simonkaufmann/AVR-USB-Flash-Drive/doc/avr_usb_flash_drive.pdf

USB Mass Storage

A USB Flash Drive with VUSB

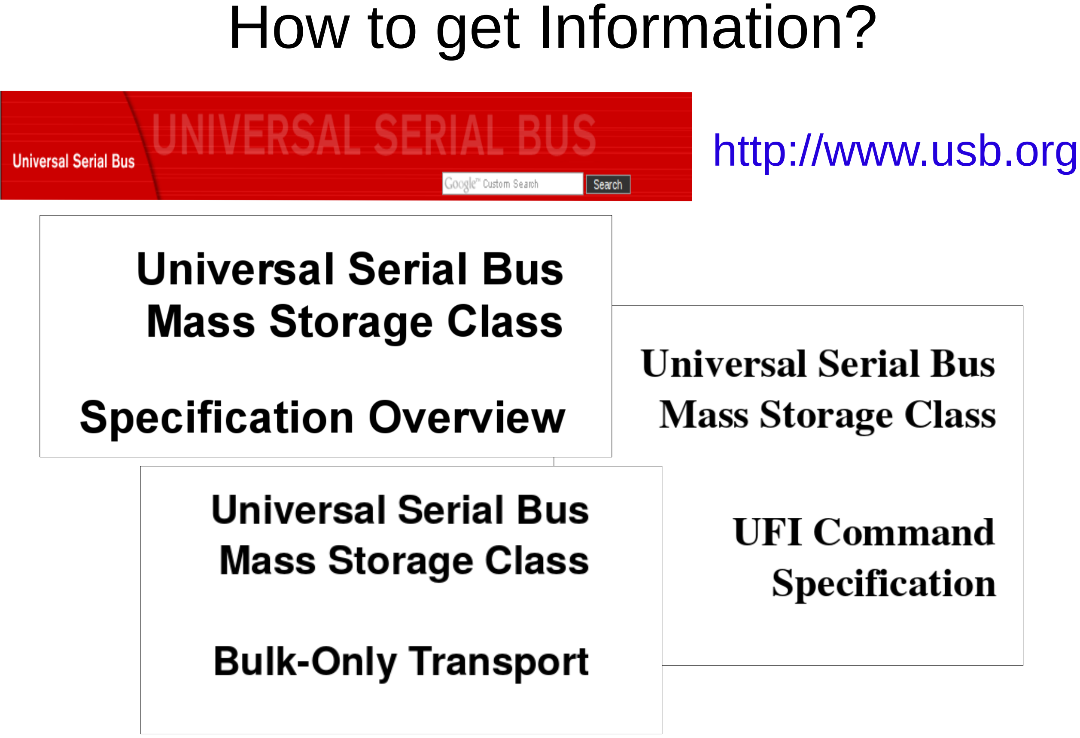
[picture p6: page 2]

How to get Information?

http://www.usb.org

VUSB and Bulk?

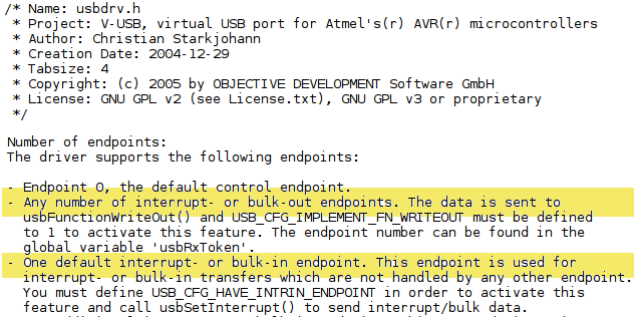
[picture p7: figure]

Linux Bulk

→ Restricts Low-Speed Bulk Endpoints

Test Low Speed Bulk Endpoints with Linux

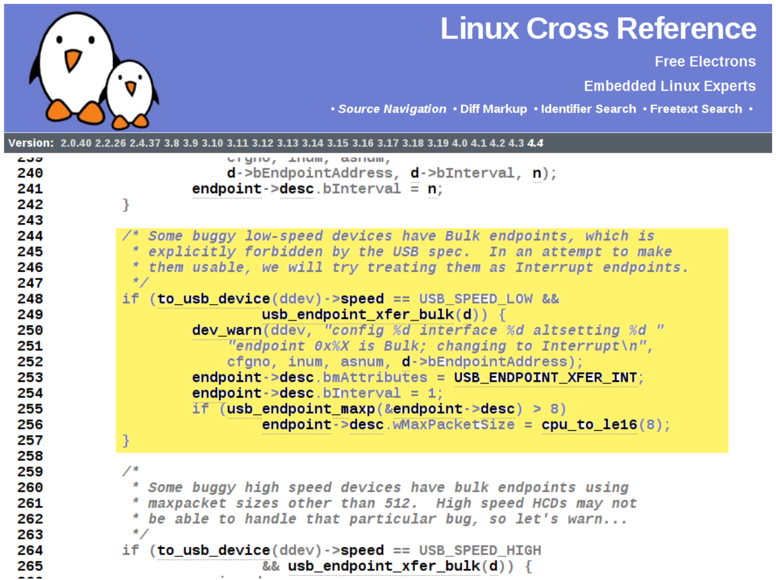
[picture p8: page 8]

Let's Hack the Kernel

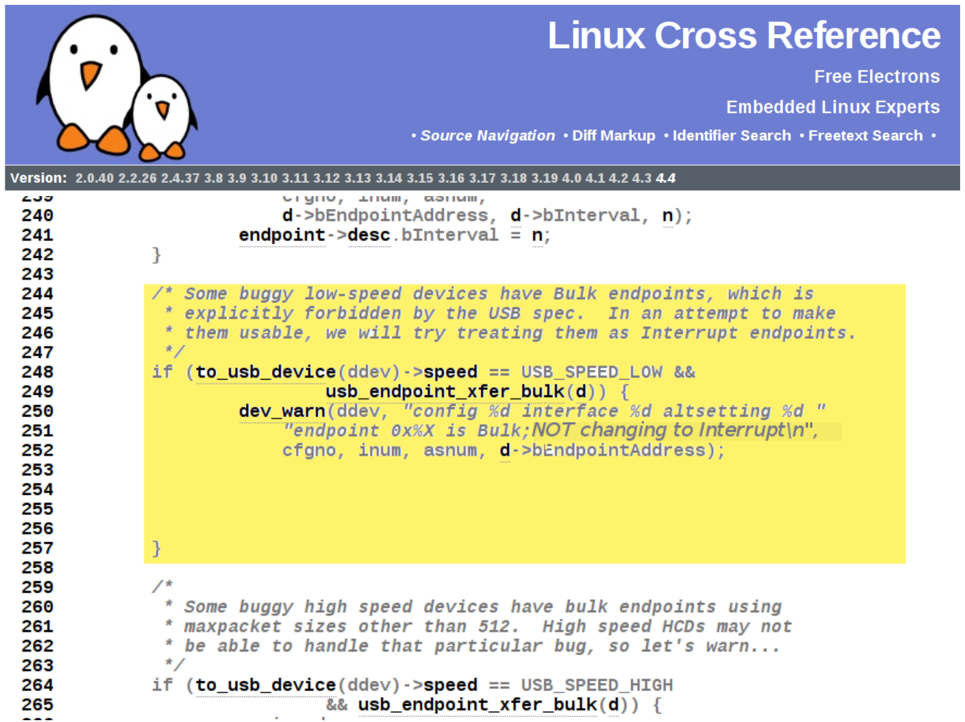
[picture p9: page 9]

Let's Hack the Kernel

Modified Kernel

Recompile kernel – 2 hours later

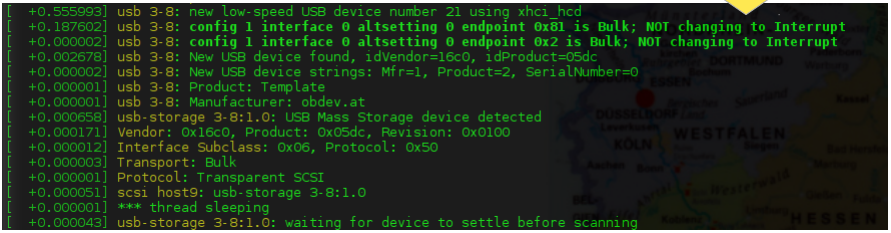
[picture p10: figure]

How is it done?

ATmega 16 EEPROM
64 kB

AVR:
- Implement Descriptor
- Implement Commands
- Read & Write EEPROM

Command Status Wrapper

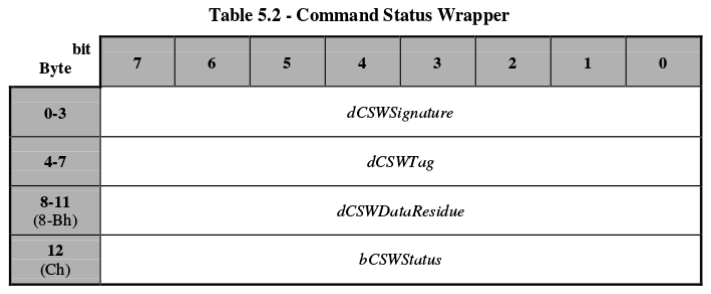
[picture p11: figure]

With RAM

ATmega 16 EEPROM
64 kB

RAM → for Buffering Data

Software

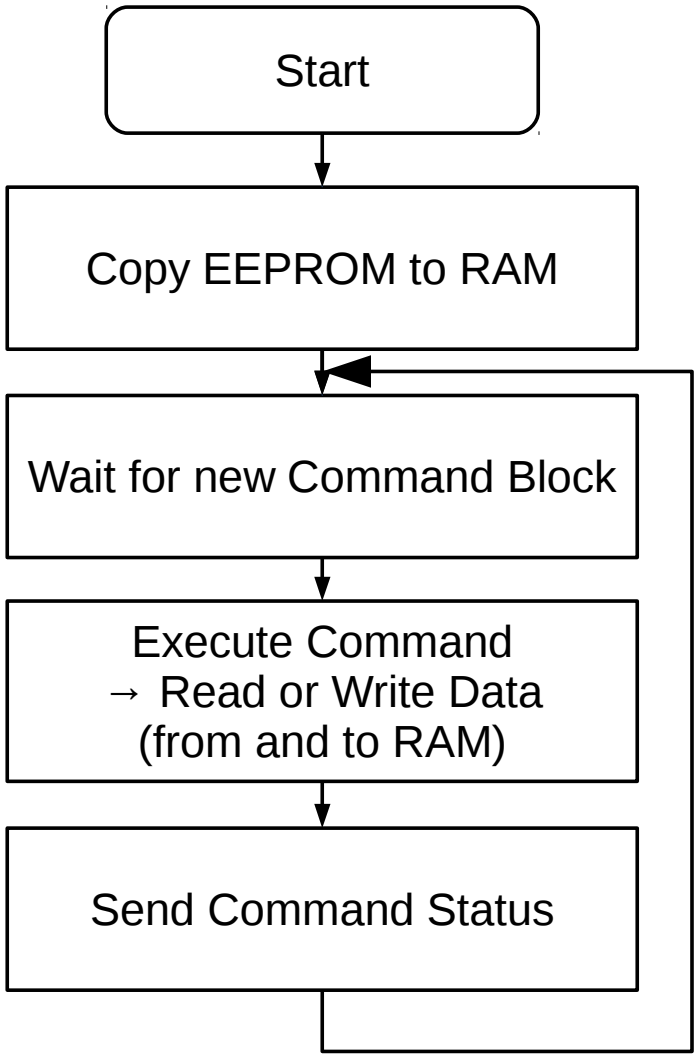
[picture p12: figure]
Start; Copy EEPROM to RAM; Wait for new Command Block; Execute Command → Read or Write Data (from and to RAM); Send Command Status

Is EEPROM
Ready?

Write next changed block
from RAM to EEPROM

Command Implementation

- Receive with usbFunctionWriteOut()
- Recognise command and create correct reponse
- Send with usbSetInterrupt()

Command Wrapper

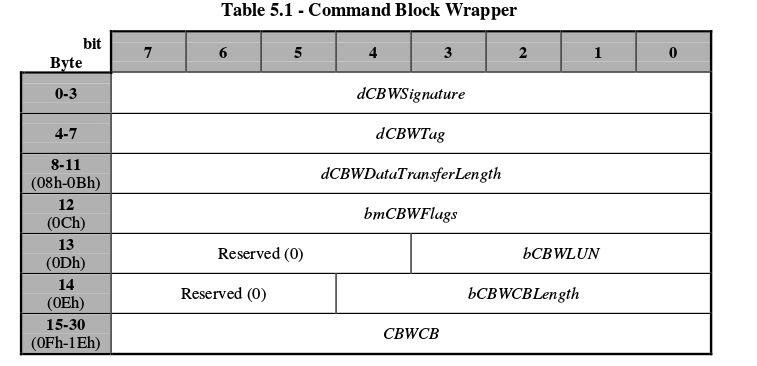
[picture p13: figure]

Command Status Wrapper

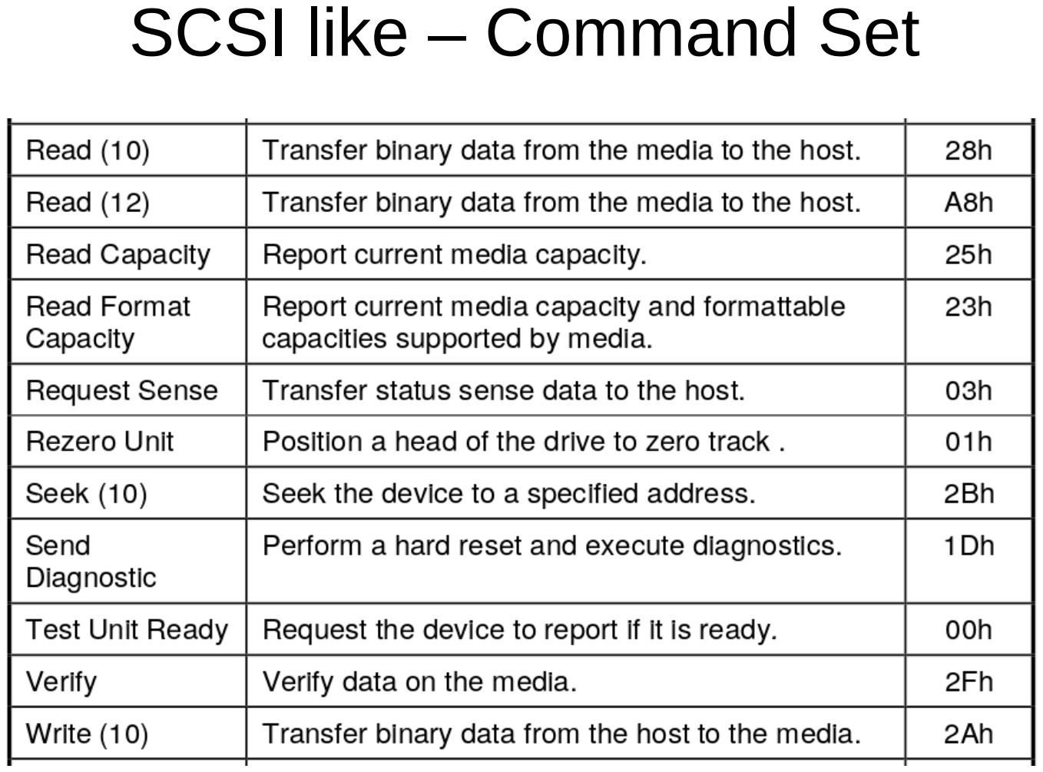
[picture p14: page 18]

SCSI like – Command Set

Read

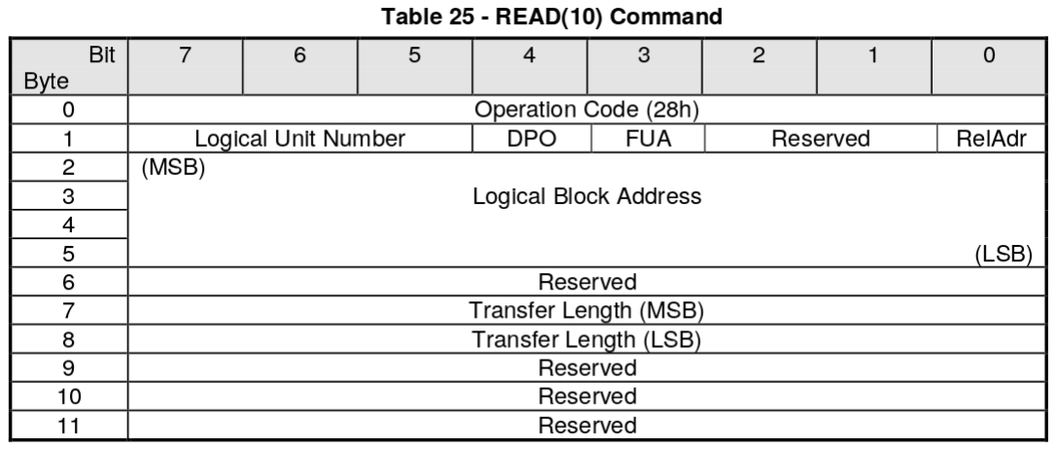
[picture p15: figure]
