simonkaufmann/AVR-USB-Flash-Drive/doc/screenshots/screen4.PNG

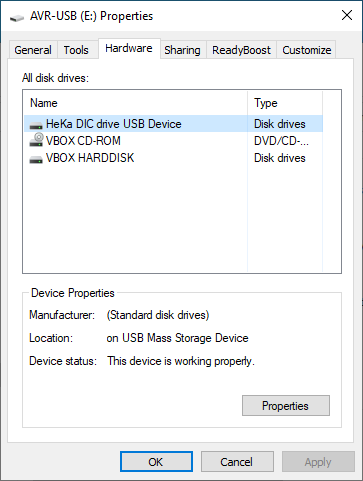
doc/screenshots/screen4.PNG
