simonkaufmann/AVR-USB-Flash-Drive/doc/screenshots/screen5.PNG

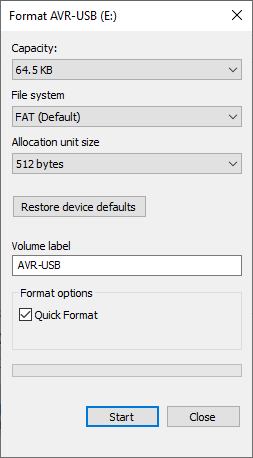
doc/screenshots/screen5.PNG
