simonkaufmann/AVR-USB-Flash-Drive/(threads)

Thread 1 (2021-01-27):

No Schematic

jamesy0ung, 2021-01-27:
Can we please get a schematic so we can make it ourselves?

simonkaufmann, 2021-01-29:
Schematic is now uploaded:
https://github.com/simonkaufmann/AVR-USB-Flash-Drive/blob/master/doc/schematic/avr_usb_flash_drive_schematic.pdf

Feel free to contact again for any further questions!

Closed 2021-01-29.
