simonkaufmann/AVR-USB-Flash-Drive/doc/schematic/avr_usb_flash_drive_schematic.pdf

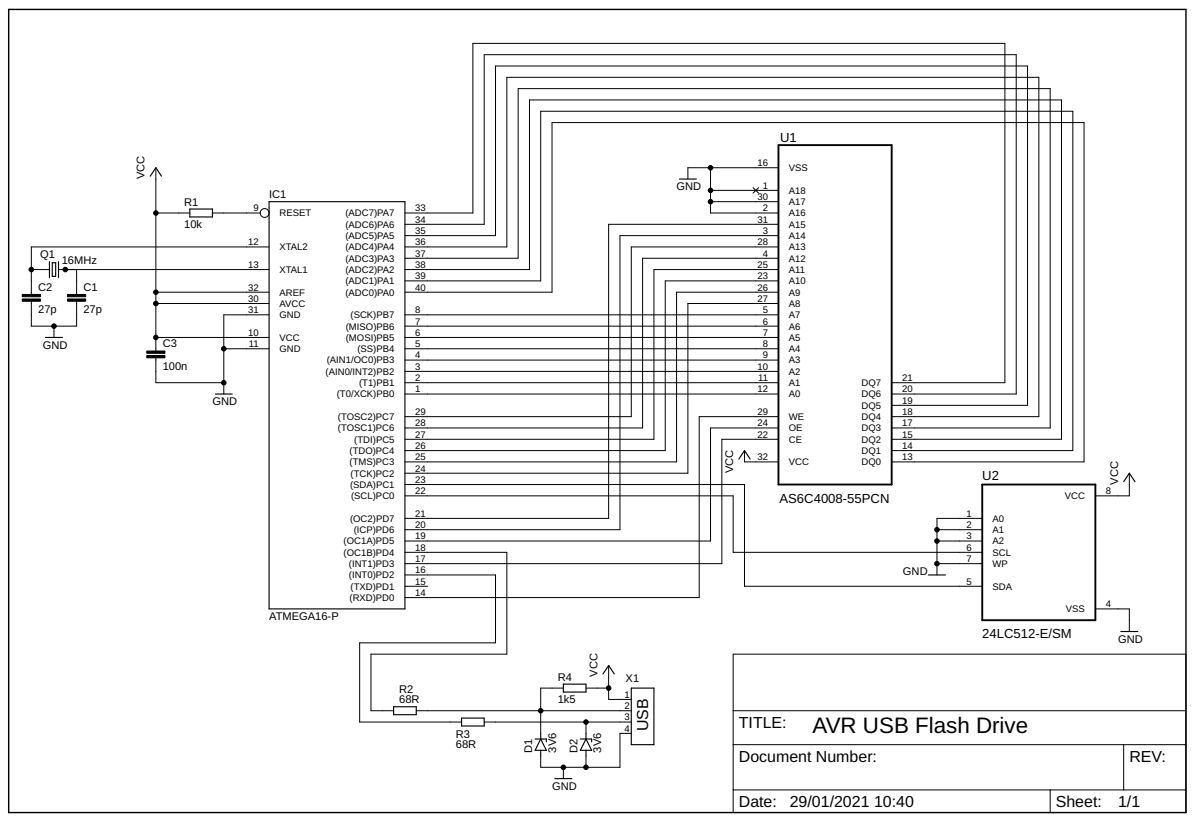
[picture p18: page 1]
