simonkaufmann/AVR-USB-Flash-Drive/doc/schematic/avr_usb_flash_drive_schematic.sch

## EAGLE design doc/schematic/avr_usb_flash_drive_schematic.sch (2021-01-29)

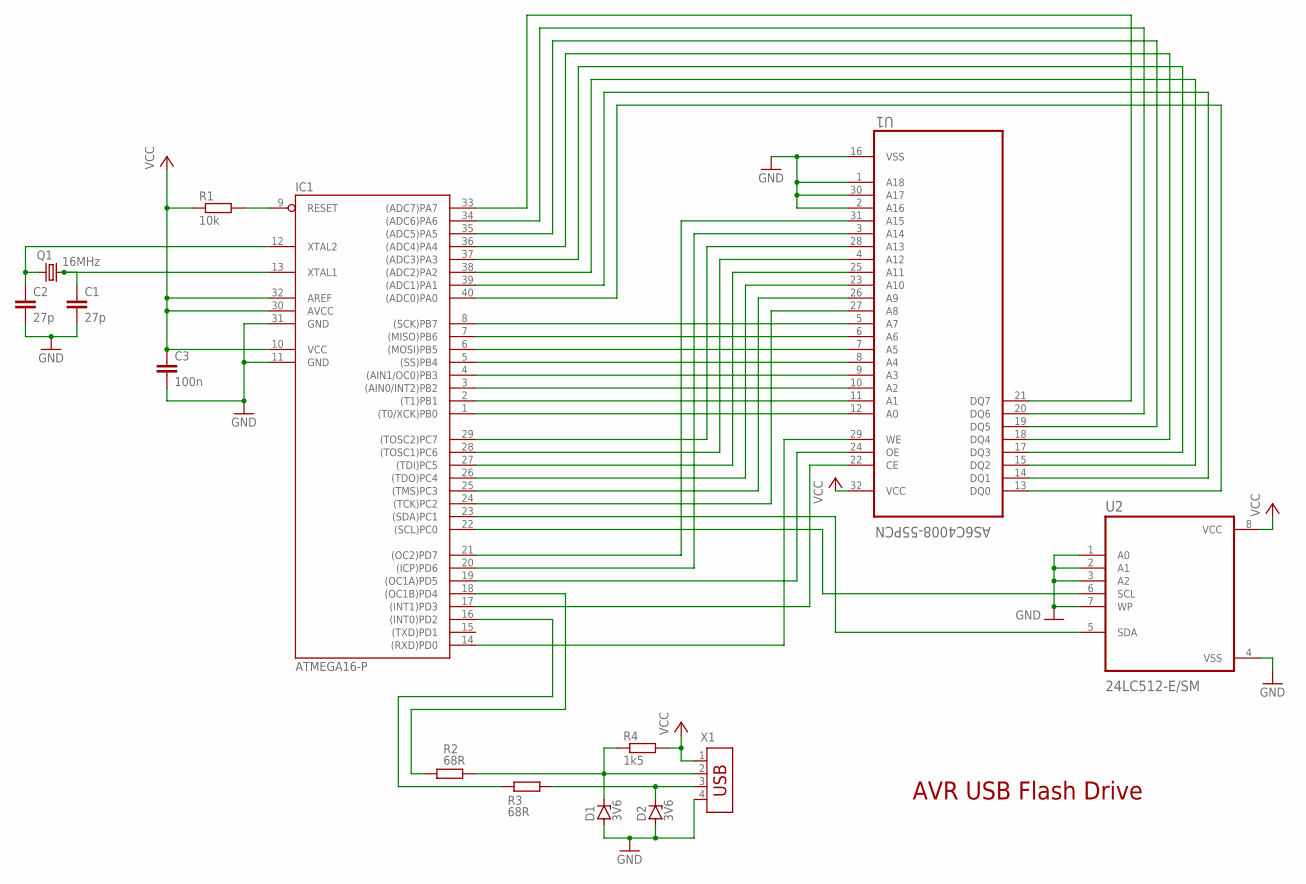
[picture p19: schematic avr_usb_flash_drive_schematic.sch]

Parts:
C1, C2: 27p; C2.5-4
C3: 100n; C2.5-4
D1, D2: 3V6; DO35Z10
IC1: ATMEGA16-P; DIL40
Q1: 16MHz; HC49/S
R1: 10k; 0207/10
R2, R3: 68R; 0207/10
R4: 1k5; 0207/10
U1: AS6C4008-55PCN; DIP254P1524X393-32
U2: 24LC512-E/SM; SOIC127P794X202-8N
X1: USB-787616; USB

Connections:
GND: C1.2, C2.2, C3.2, D1.A, D2.A, IC1.11 (GND), IC1.31 (GND), U1.1 (A18), U1.2 (A16), U1.16 (VSS), U1.30 (A17), U2.1 (A0), U2.2 (A1), U2.3 (A2), U2.4 (VSS), U2.7 (WP), X1.4
unnamed: C1.1, IC1.13 (XTAL1), Q1.1
unnamed: IC1.9 (RESET), R1.2
unnamed: IC1.1 ((T0/XCK)PB0), U1.12 (A0)
unnamed: IC1.2 ((T1)PB1), U1.11 (A1)
unnamed: IC1.3 ((AIN0/INT2)PB2), U1.10 (A2)
unnamed: IC1.4 ((AIN1/OC0)PB3), U1.9 (A3)
unnamed: IC1.5 ((SS)PB4), U1.8 (A4)
unnamed: IC1.6 ((MOSI)PB5), U1.7 (A5)
unnamed: IC1.7 ((MISO)PB6), U1.6 (A6)
unnamed: IC1.8 ((SCK)PB7), U1.5 (A7)
unnamed: IC1.24 ((TCK)PC2), U1.27 (A8)
unnamed: IC1.25 ((TMS)PC3), U1.26 (A9)
unnamed: IC1.26 ((TDO)PC4), U1.23 (A10)
unnamed: IC1.27 ((TDI)PC5), U1.25 (A11)
unnamed: IC1.28 ((TOSC1)PC6), U1.4 (A12)
unnamed: IC1.29 ((TOSC2)PC7), U1.28 (A13)
unnamed: IC1.20 ((ICP)PD6), U1.3 (A14)
unnamed: IC1.21 ((OC2)PD7), U1.31 (A15)
unnamed: IC1.40 ((ADC0)PA0), U1.13 (DQ0)
unnamed: IC1.39 ((ADC1)PA1), U1.14 (DQ1)
unnamed: IC1.38 ((ADC2)PA2), U1.15 (DQ2)
unnamed: IC1.37 ((ADC3)PA3), U1.17 (DQ3)
unnamed: IC1.36 ((ADC4)PA4), U1.18 (DQ4)
unnamed: IC1.35 ((ADC5)PA5), U1.19 (DQ5)
unnamed: IC1.34 ((ADC6)PA6), U1.20 (DQ6)
unnamed: IC1.33 ((ADC7)PA7), U1.21 (DQ7)
unnamed: IC1.14 ((RXD)PD0), U1.29 (WE)
unnamed: IC1.19 ((OC1A)PD5), U1.24 (OE)
unnamed: IC1.17 ((INT1)PD3), U1.22 (CE)
unnamed: D1.C, R2.2, R4.1, X1.2
unnamed: IC1.22 ((SCL)PC0), U2.6 (SCL)
unnamed: IC1.23 ((SDA)PC1), U2.5 (SDA)
unnamed: C2.1, IC1.12 (XTAL2), Q1.2
unnamed: IC1.18 ((OC1B)PD4), R2.1
unnamed: D2.C, R3.2, X1.3
unnamed: IC1.16 ((INT0)PD2), R3.1
VCC: C3.1, IC1.10 (VCC), IC1.30 (AVCC), IC1.32 (AREF), R1.1, R4.2, U1.32 (VCC), U2.8 (VCC), X1.1

Notes on the sheet:
AVR USB Flash Drive
