simonkaufmann/AVR-USB-Flash-Drive/(notices)

Notices in the files:
src/twi.c:
modify it under the terms of the GNU General Public License as published by
the Free Software Foundation, either version 3 of the License, or
(at your option) any later version.
src/commands.c:
VUSB flash drive is free software: you can redistribute it and/or modify
it under the terms of the GNU General Public License as published by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
